suzhan06yyds/stm32-iot-collector/images/af64fc5e98fe8de4655975db482f3f01.jpg

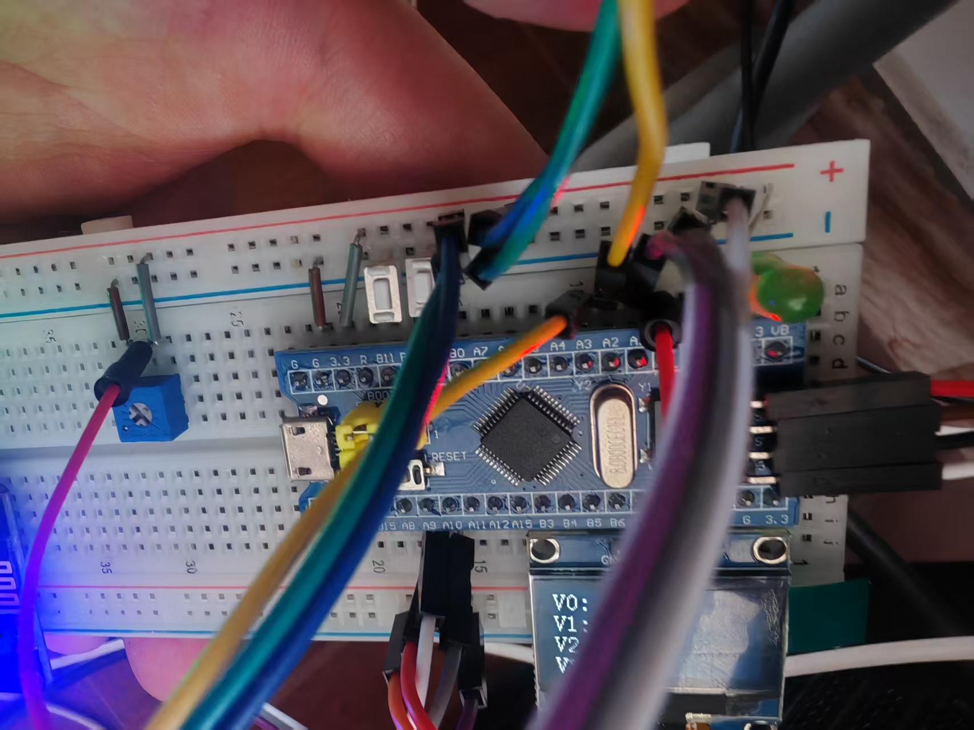
images/af64fc5e98fe8de4655975db482f3f01.jpg
