suzhan06yyds/stm32-iot-collector/images/6c712e1c53ddb7e347b5743749fcfce9.jpg

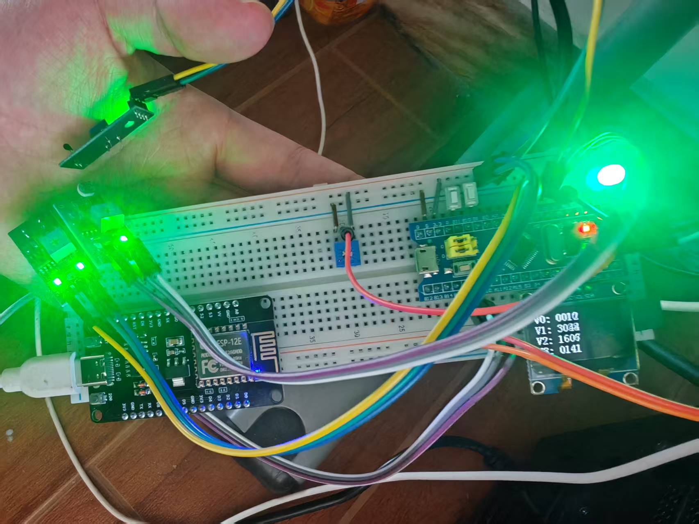
images/6c712e1c53ddb7e347b5743749fcfce9.jpg
