suzhan06yyds/stm32-iot-collector/docs/README.md

# docs

本目录存放项目配套说明文档。

- 接线表：见主 README 第 3 节（STM32 PA9→ESP8266 RX、PA10→TX、GND 共地）
- 数据帧协议：见主 README 第 4 节（6 行组包，9600 波特率）
- 排障记录：见主 README 第 7 节（7 条踩坑与解决）
