suzhan06yyds/stm32-iot-collector/images/README.md

# images

存放实物照片与运行截图（上传前把照片放到本目录）：

1. `overview.jpg` — 通电整体工作照（STM32 + ESP8266 + OLED 显示数据）
2. `web_page.png` — ESP8266 网页显示截图（多行环境数据 + 延迟 ms）
3. `bemfa_cloud.png` — 巴法云 esp001 主题消息截图
4. `wiring.jpg` — PA9/PA10/GND 接线特写

命名用英文/拼音，单张 ≤1MB。
