suzhan06yyds/stm32-iot-collector/images/529cbdde7515dabc8a0148d04f9fc1d8.jpg

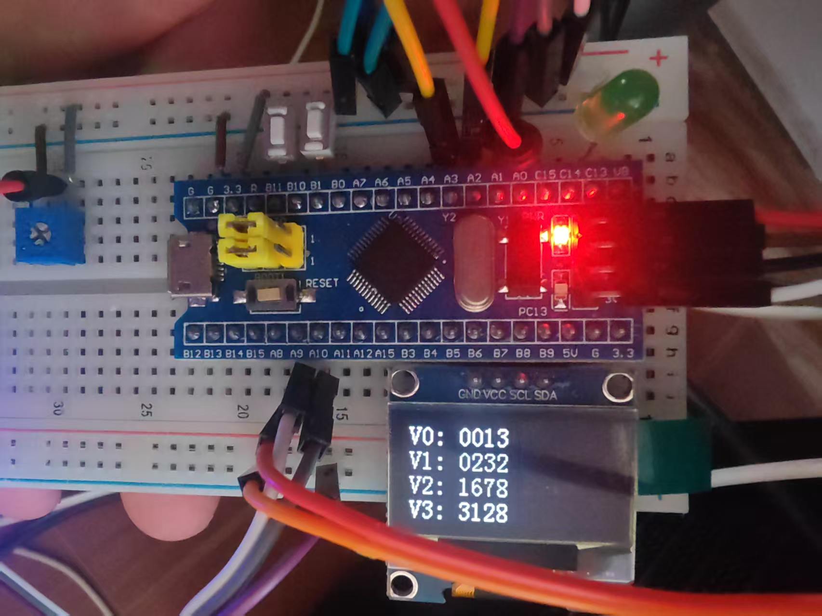
images/529cbdde7515dabc8a0148d04f9fc1d8.jpg
