suzhan06yyds/stm32-iot-collector/images/屏幕截图 2026-10-28 132721.png

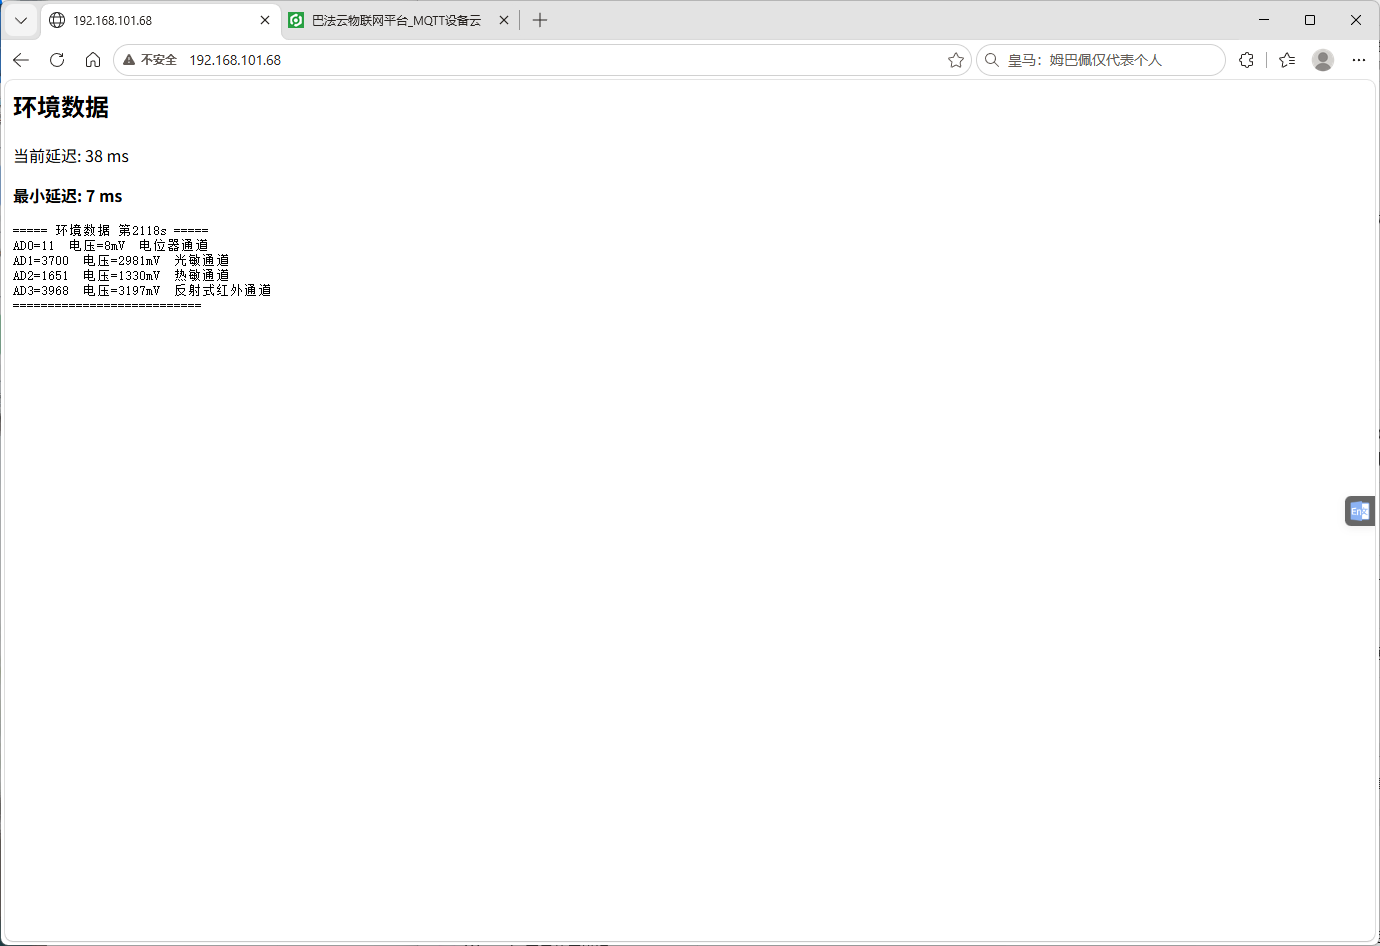
images/屏幕截图 2026-10-28 132721.png
