suzhan06yyds/stm32-iot-collector/firmware/Hardware/Key.c

#include "stm32f10x.h"                  // Device header
#include "Delay.h"

volatile uint8_t key1_flag = 0;		// KEY1(PB1) 按下标志
volatile uint8_t key2_flag = 0;		// KEY2(PB11) 按下标志

void Key_Init(void)
{
	RCC_APB2PeriphClockCmd(RCC_APB2Periph_GPIOB, ENABLE);
	RCC_APB2PeriphClockCmd(RCC_APB2Periph_AFIO, ENABLE);
	
	GPIO_InitTypeDef GPIO_InitStructure;
	GPIO_InitStructure.GPIO_Mode = GPIO_Mode_IPU;	
	GPIO_InitStructure.GPIO_Pin = GPIO_Pin_1 | GPIO_Pin_11;
	GPIO_InitStructure.GPIO_Speed = GPIO_Speed_50MHz;
	GPIO_Init(GPIOB, &GPIO_InitStructure);
	
	GPIO_EXTILineConfig(GPIO_PortSourceGPIOB, GPIO_PinSource1);	// PB1 -> EXTI1
	GPIO_EXTILineConfig(GPIO_PortSourceGPIOB, GPIO_PinSource11);	// PB11 -> EXTI11

	EXTI_InitTypeDef EXTI_InitStructure;
	EXTI_InitStructure.EXTI_Line = EXTI_Line1 | EXTI_Line11;
	EXTI_InitStructure.EXTI_Mode = EXTI_Mode_Interrupt;
	EXTI_InitStructure.EXTI_Trigger = EXTI_Trigger_Falling;		
	EXTI_InitStructure.EXTI_LineCmd = ENABLE;
	EXTI_Init(&EXTI_InitStructure);

	NVIC_InitTypeDef NVIC_InitStructure;
	NVIC_InitStructure.NVIC_IRQChannel = EXTI1_IRQn;
	NVIC_InitStructure.NVIC_IRQChannelCmd = ENABLE;
	NVIC_InitStructure.NVIC_IRQChannelPreemptionPriority = 2;
	NVIC_InitStructure.NVIC_IRQChannelSubPriority = 0;
	NVIC_Init(&NVIC_InitStructure);

	NVIC_InitStructure.NVIC_IRQChannel = EXTI15_10_IRQn;
	NVIC_InitStructure.NVIC_IRQChannelCmd = ENABLE;
	NVIC_InitStructure.NVIC_IRQChannelPreemptionPriority = 2;
	NVIC_InitStructure.NVIC_IRQChannelSubPriority = 0;
	NVIC_Init(&NVIC_InitStructure);
}

void EXTI1_IRQHandler(void)			// KEY1: PB1
{
	if(EXTI_GetITStatus(EXTI_Line1) == SET)
	{
		EXTI_ClearITPendingBit(EXTI_Line1);
		key1_flag = 1;
	}
}

void EXTI15_10_IRQHandler(void)		// KEY2: PB11
{
	if(EXTI_GetITStatus(EXTI_Line11) == SET)
	{
		EXTI_ClearITPendingBit(EXTI_Line11);
		key2_flag = 1;
	}
}
